maxwolfs/Delayed-Gratification-Actuator/assets/doc-notes-page-04.png

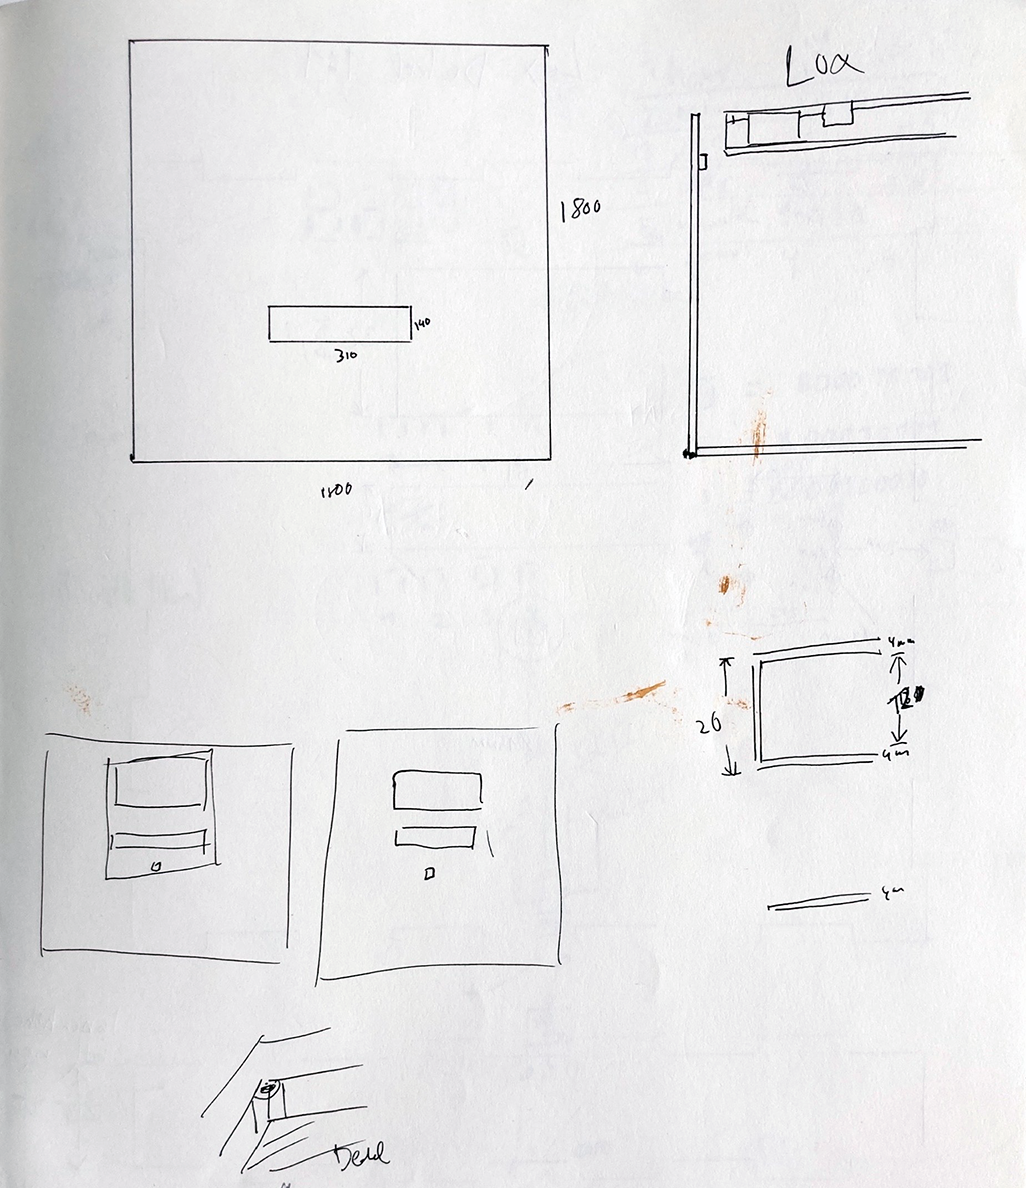
assets/doc-notes-page-04.png
