maxwolfs/Delayed-Gratification-Actuator/assets/doc-notes-page-05.png

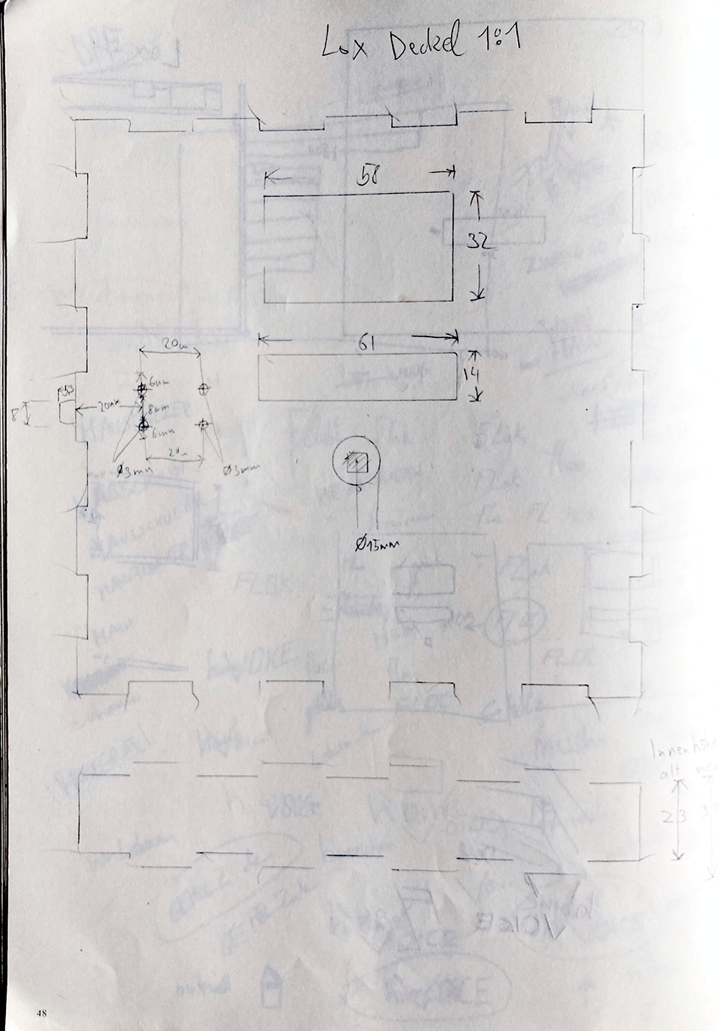
assets/doc-notes-page-05.png
