maxwolfs/Delayed-Gratification-Actuator/assets/doc-notes-page-07.png

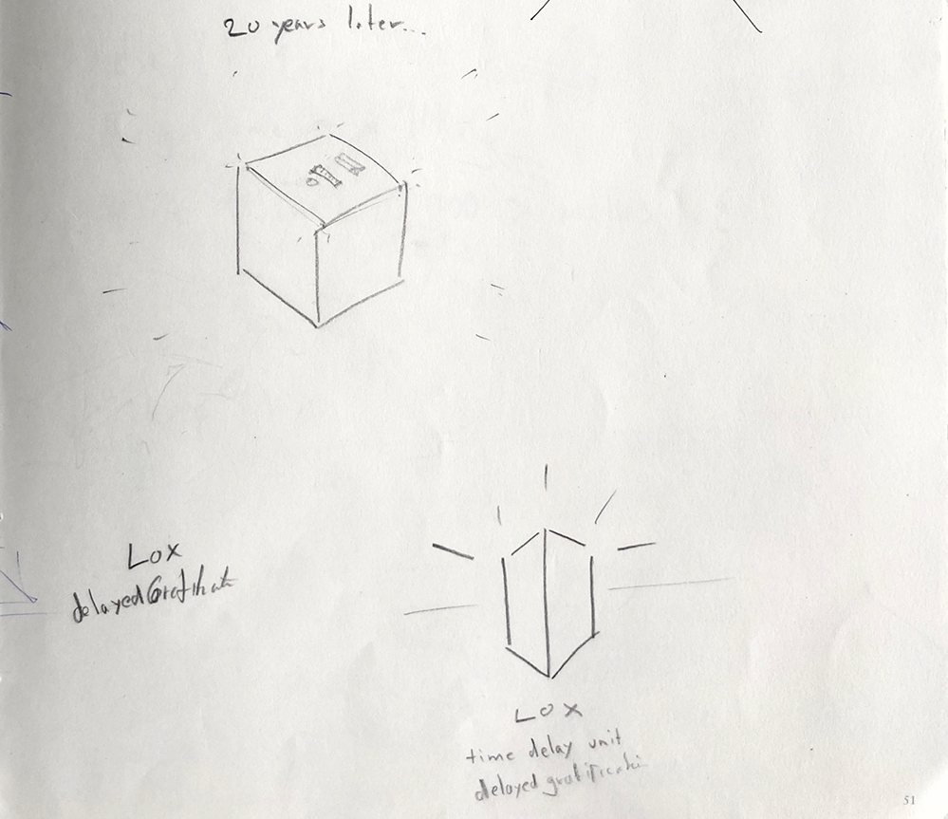
assets/doc-notes-page-07.png
