maxwolfs/Delayed-Gratification-Actuator/assets/doc-notes-page-11.png

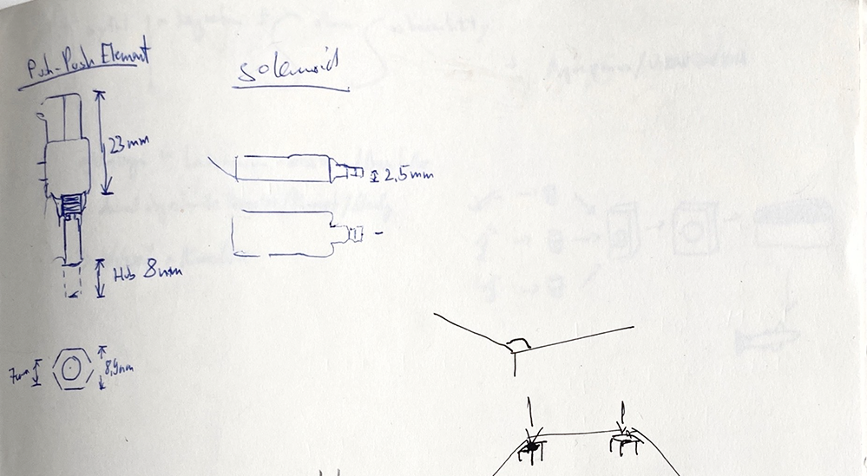
assets/doc-notes-page-11.png
