maxwolfs/Delayed-Gratification-Actuator/assets/maxresdefault.jpg

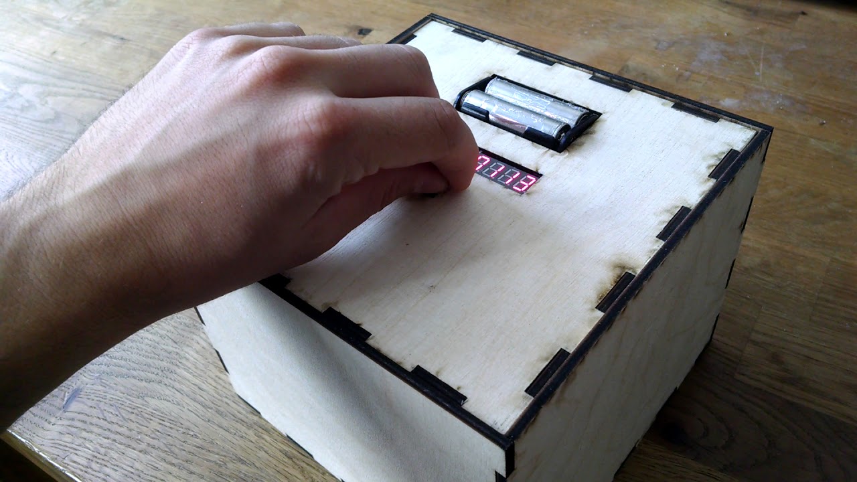
assets/maxresdefault.jpg
